1012276/AFS30_testsysteem_Stedin/Altium/Testopstelling DA_BOX_V2/BOM/Testopstelling_DA_BOX_Stedin_V2.xlsx

Comment | Description | Designator | Footprint | LibRef | Quantity
LM61495RPHR | No Description Available | 1 | RPH0016A | LM61495RPHR | 1
EEHZU1J151V | Aluminum Hybrid Polymer Capacitors 150uF 20% 63V Life 4000Hours AEC-Q200 RADIAL SMT | C1 | FP-EEH-G16-V-MFG | CMP-05428-001018-1 | 1
10uF | CAP CER 10UF 50V X7R 1210 | C2, C4 | FP-GRM32-MFG | CMP-2000-05261-2 | 2
1 uF | CAP CER 1 UF 50V 5% X7R 0603 | C3, C5, C12, C16 | FP-C0603C-CF-MFG | CMP-2006-03056-2 | 4
22μF | Multilayer Ceramic Capacitors 22μF ±20% 10V X5R SMD 0805 | C6, C7, C8 | FP-C2012-125-0_2-MFG | CMP-08246-005813-1 | 3
100nF | CAP CER 0.1UF 16V X7R 0402 | C9, C11, C24, C25, C28, C30, C32, C33, C39, C41, C42, C45, C48, C49, C50, C51, C52, C53, C54, C55, C56, C59, C60, C61, C62, C65, C67, C68, C69, C70 | FP-GRM15-MFG | CMP-2100-03641-2 | 30
10pF | CAP CER 10pF 16V X7R 0402 | C10 | FP-GRM15-MFG | CMP-2100-03641-2 | 1
4.7 uF | CAP CER 4.7 UF 50V 5% X7R 0603 | C13, C17, C29, C58 | FP-C0603C-CF-MFG | CMP-2006-03056-2 | 4
2.2 uF | CAP CER 2.2 UF 50V 5% X7R 0603 | C14, C15, C46, C47 | FP-C0603C-CF-MFG | CMP-2006-03056-2 | 4
10 UF | CAP CER 10 UF 16V X7R 0603 | C18, C20 | FP-CC0603-DA-MFG | CMP-2000-05002-2 | 2
0.1 uF | CAP CER 0.1UF 16V X7R 0603 | C19, C21 | FP-CC0603-DA-MFG | CMP-2000-05002-2 | 2
150 nF | CAP CER 0.1UF 16V X7R 0603 | C22 | FP-CC0603-DA-MFG | CMP-2000-05002-2 | 1
1nF | General Purpose Ceramic Capacitor, 0603, 1nF, 10%, X7R, 15%, 50V | C23, C26, C27 | FP-CC0603-DA-MFG | CMP-2000-05002-2 | 3
2.2 nF | AC0603 2.2 pF NP0 5.00% 50 V | C31 | FP-AC0603-MFG | CMP-03422-001062-1 | 1
68 pF | AC0603 68 pF NP0 5.00% 50 V | C34 | FP-AC0603-MFG | CMP-03422-001062-1 | 1
15 nF | CAP CER 15 nF 50V 5% X7R 0603 Eurocircuits generic components: GPC0603153 | C36, C38 | FP-C0603C-CF-MFG | CMP-2006-03056-2 | 2
330 pF | AC0603 330 pF NP0 5.00% 50 V | C37 | FP-AC0603-MFG | CMP-03422-001062-1 | 1
15 pF | AC0603 15 pF NP0 5.00% 50 V | C43, C44 | FP-AC0603-MFG | CMP-03422-001062-1 | 2
1uF | CAP CER 1UF 16V X7R 0402 | C57, C64, C66 | FP-GRM15-MFG | CMP-2100-03641-2 | 3
10nF | CAP CER 10nF 16V X7R 0402 | C63 | FP-GRM15-MFG | CMP-2100-03641-2 | 1
4.7uF | Polarized Capacitor (Radial) | C71 | TAN-A | Cap Pol1 | 1
475900001 |  | CN1 | MOLEX_47590001 | 475900001 | 1
ESDA6V1BC6 | 4-line ESD protection | D1 | 3 | ESDA6V1BC6 | 1
DNP_0603 | Is just 0603 footprint. So that you can solder 0603 components on it after you ordered youre PCB. | DNP1, DNP2 | DNP_0603_footprint | DNP_0603 | 2
DAC8564IAPW | Integrated Circuit | IC1 | SOP65P640X120-16N | DAC8564IAPW | 1
MAX22506EASA+ | Integrated Circuit | IC2 | SOIC127P600X175-8N | MAX22506EASA+ | 1
2269-2 | CONN DBL BANANA JACK TURRET | J1 | FP-2269-2-MFG | CMP-73906-000010-1 | 1
61500814221 |  | J2, J3, J4, J5, J6, J7, J8, J10, J15 | 61500814221 | CMP-1502-01695-2 | 9
TSW-104-22-G-S | GENERIC PART NUMBER: GPHA-1X04 CONN HEADER VERT 4POS 2.54MM | J9, J11, J12 | FP-TSW-104-22-G-S-MFG | CMP-02766-001236-1 | 3
FTSH-107-01-L-DV-K-A | Board Connector, 14 Contact(s), 2 Row(s), Male, Straight, 0.05 inch Pitch, Surface Mount Terminal, Locking, Receptacle | J14 | FTSH-107-XX-YYY-DV-K-A | FTSH-107-01-L-DV-K-A | 1
XAL6060-822MEC | 8.2 uH Inductor | L1 | XAL6060822MEC | XAL6060-822MEC | 1
ASMT-YTD7-0AA02 | LED | LED1 | ASMTYTD70AA02 | ASMT-YTD7-0AA02 | 1
SML-LX1206SRC-TR | LED | LED2 | SMLLX1206SRCTR | SML-LX1206SRC-TR | 1
150060VS75003 | LED | LED3 | 150060VS75003 | 150060VS75003 | 1
TSW-102-26-T-S | 0.025" SQ Post Header, Through-hole, Vertical, -55 to 105 degC, 2.54 mm Pitch, 2-Pin, Male, RoHS | P1, P2, P3, P4, P5, P6, P7, P8 | SMTC-TSW-102-26-XX-S | CMP-1024-00328-1 | 8
100k | RES 100K OHM 1% 1/16W 0402 | R1, R3 | FP-CRCW0402-C-e3-MFG | CMP-02407-010951-1 | 2
4.99k | RES Thick Film, 4.99kΩ, 1%, 0.063W, 100ppm/°C, 0402 | R2 | FP-CRCW0402-e3-MFG | CMP-2002-00057-2 | 1
43k | RES 43k OHM 1% 1/16W 0402 | R4 | FP-CRCW0402-C-e3-MFG | CMP-02407-010951-1 | 1
82k | RES 100K OHM 1% 1/16W 0402 | R5 | FP-CRCW0402-C-e3-MFG | CMP-02407-010951-1 | 1
270k | RES SMD 20K OHM 1% 1/8W 0805 | R6 | FP-ERJ6EN-MFG | CMP-2001-00027-2 | 1
20k | RES SMD 20K OHM 1% 1/8W 0805 | R7, R8 | FP-ERJ6EN-MFG | CMP-2001-00027-2 | 2
0 | CRCW12060000ZSTA Zero Ohm Resistor, Jumper, 1206 [3216 Metric], Thick Film, 250 mW, Surface Mount | R9, R10, R11, R12, R13, R14, R16, R17, R18, R19, R20, R21, R22, R23, R24, R25, R26, R27, R28, R29, R30, R31, R32, R33, R52, R55, R56, R65, R78 | FP-CRCW1206-MFG | CMP-00030-39388935-1 | 29
10k | Res Thick Film 0603 11kΩ 1% 0.1W ±100ppm/°C Molded SMD T/R, Res Thick Film 0603 10kΩ 1% 0.1W ±100ppm/°C Molded SMD T/R Generic part Eurocircuits: GPR060310K | R15, R35, R36, R38, R40, R43, R46, R49, R51, R53 | FP-RC1608-IPC_B | CMP-13261-004935-1 | 10
100 | Res Thick Film 0603 100Ω 1% 0.1W ±100ppm/°C Molded SMD T/R | R34, R37, R47 | FP-RC1608-IPC_B | CMP-13261-004935-1 | 3
620 | Res Thick Film 0603 620Ω 1% 0.1W ±100ppm/°C Molded SMD T/R | R39 | FP-RC1608-IPC_B | CMP-13261-004935-1 | 1
51k | Res Thick Film 0603 51kΩ 1% 0.1W ±100ppm/°C Molded SMD T/R | R41 | FP-RC1608-IPC_B | CMP-13261-004935-1 | 1
11k | Res Thick Film 0603 11kΩ 1% 0.1W ±100ppm/°C Molded SMD T/R | R42, R44, R48, R50 | FP-RC1608-IPC_B | CMP-13261-004935-1 | 4
3k | Res Thick Film 0603 3kΩ 1% 0.1W ±100ppm/°C Molded SMD T/R | R45 | FP-RC1608-IPC_B | CMP-13261-004935-1 | 1
22 | Res Thick Film 0603 22Ω 1% 0.1W ±100ppm/°C Molded SMD T/R Generic part Eurocircuits: GPR060310K | R54 | FP-RC1608-IPC_B | CMP-13261-004935-1 | 1
120 | CRCW12060000ZS120 Ohm Resistor, Jumper, 1206 [3216 Metric], Thick Film, 250 mW, Surface Mount | R57 | FP-CRCW1206-MFG | CMP-00030-39388935-1 | 1
39 | Res Thick Film 0603 39Ω 1% 0.1W ±100ppm/°C Molded SMD T/R Generic part Eurocircuits: GPR060310K | R58, R59 | FP-RC1608-IPC_B | CMP-13261-004935-1 | 2
82 | Res Thick Film 0603 82Ω 1% 0.1W ±100ppm/°C Molded SMD T/R Generic part Eurocircuits: GPR060310K | R60 | FP-RC1608-IPC_B | CMP-13261-004935-1 | 1
620 | Resistor | R61 | 0603R | Res1 | 1
47K | Resistor | R62 | 0603R | res1 | 1
10K | Resistor | R63, R67 | 0603R | Res1 | 2
220 | RES Thick Film, 220Ω, 1%, 0.125W, 100ppm/°C, 0805 | R64 | FP-CRCW0805-e3-MFG | CMP-2001-03682-2 | 1
4.7K | Resistor | R66 | 0603R | res1 | 1
0 | Chip Resistor, 0 Ohm, +/- 1%, 0.125 W, -55 to 155 degC, 0805 (2012 Metric), RoHS, Tape and Reel | R68, R69, R70, R71, R72, R73, R74, R75, R76 | RESC2013X70X40NL20T20 | CMP-1665-00002-5 | 9
0 | Chip Resistor, 0 Ohm, +/- 5%, 0.1 W, -55 to 155 degC, 0603 (1608 Metric), RoHS, Tape and Reel | R77 | RESC1608X55X25ML10T15 | CMP-2100-03667-1 | 1
Open | Circuit Breaker | SB1 | SB_0603 | Circuit Breaker | 1
B3F-1000 | Tactile Switch, SPST-NO, 0.05 A, 5 to 24 V, -25 to 70 degC, 4-Pin THD, RoHS, Bulk | SW1, SW2, SW3, SW4 | OMRON-B3F-1000-4_V | CMP-1677-00002-1 | 4
LM2776DBVR | IC REG CHARGE PUMP INV SOT23 | U1 | FP-DBV0006A-MFG | CMP-04918-000109-1 | 1
LT3021ES8#PBF | Low 160 mV Dropout Voltage, Internal PNP Pass Element, 200 mV Reference Voltage, 0.9 to 10 V Vin, Adjustable Vout, 8-pin SOIC (S8-8), -40 to 125 degC, Pb-Free | U2 | LT-S8-8_L | CMP-0476-01501-1 | 1
OPA1652AID | No Description Available | U3, U4, U5, U6 | D8 | OPA1652AID | 4
STM32F446ZET7 | ARM Cortex-M4 32-bit MCU+FPU, 512 KB Flash, 128 KB Internal RAM, 114 I/Os, 144-Pin LQFP, -40 to 105 degC, Tray | U7 | STM-LQFP144_M | CMP-0243-00227-1 | 1
STMPS2151STR |  | U8 | SOT-23-5L | STMPS2141STR | 1
ABM8G-12.000MHZ-18-D2Y-T | Crystal 12MHz ±20ppm (Tol) ±30ppm (Stability) 18pF FUND 120Ω 4-Pin SMD T/R | Y1 | FP-ABM8G-MFG | CMP-2000-05039-3 | 1
