1012276/AFS30_testsysteem_Stedin/Altium/Testopstelling DA_BOX_V1/Schemas/Testopstelling_DA_BOX_Stedin.pdf

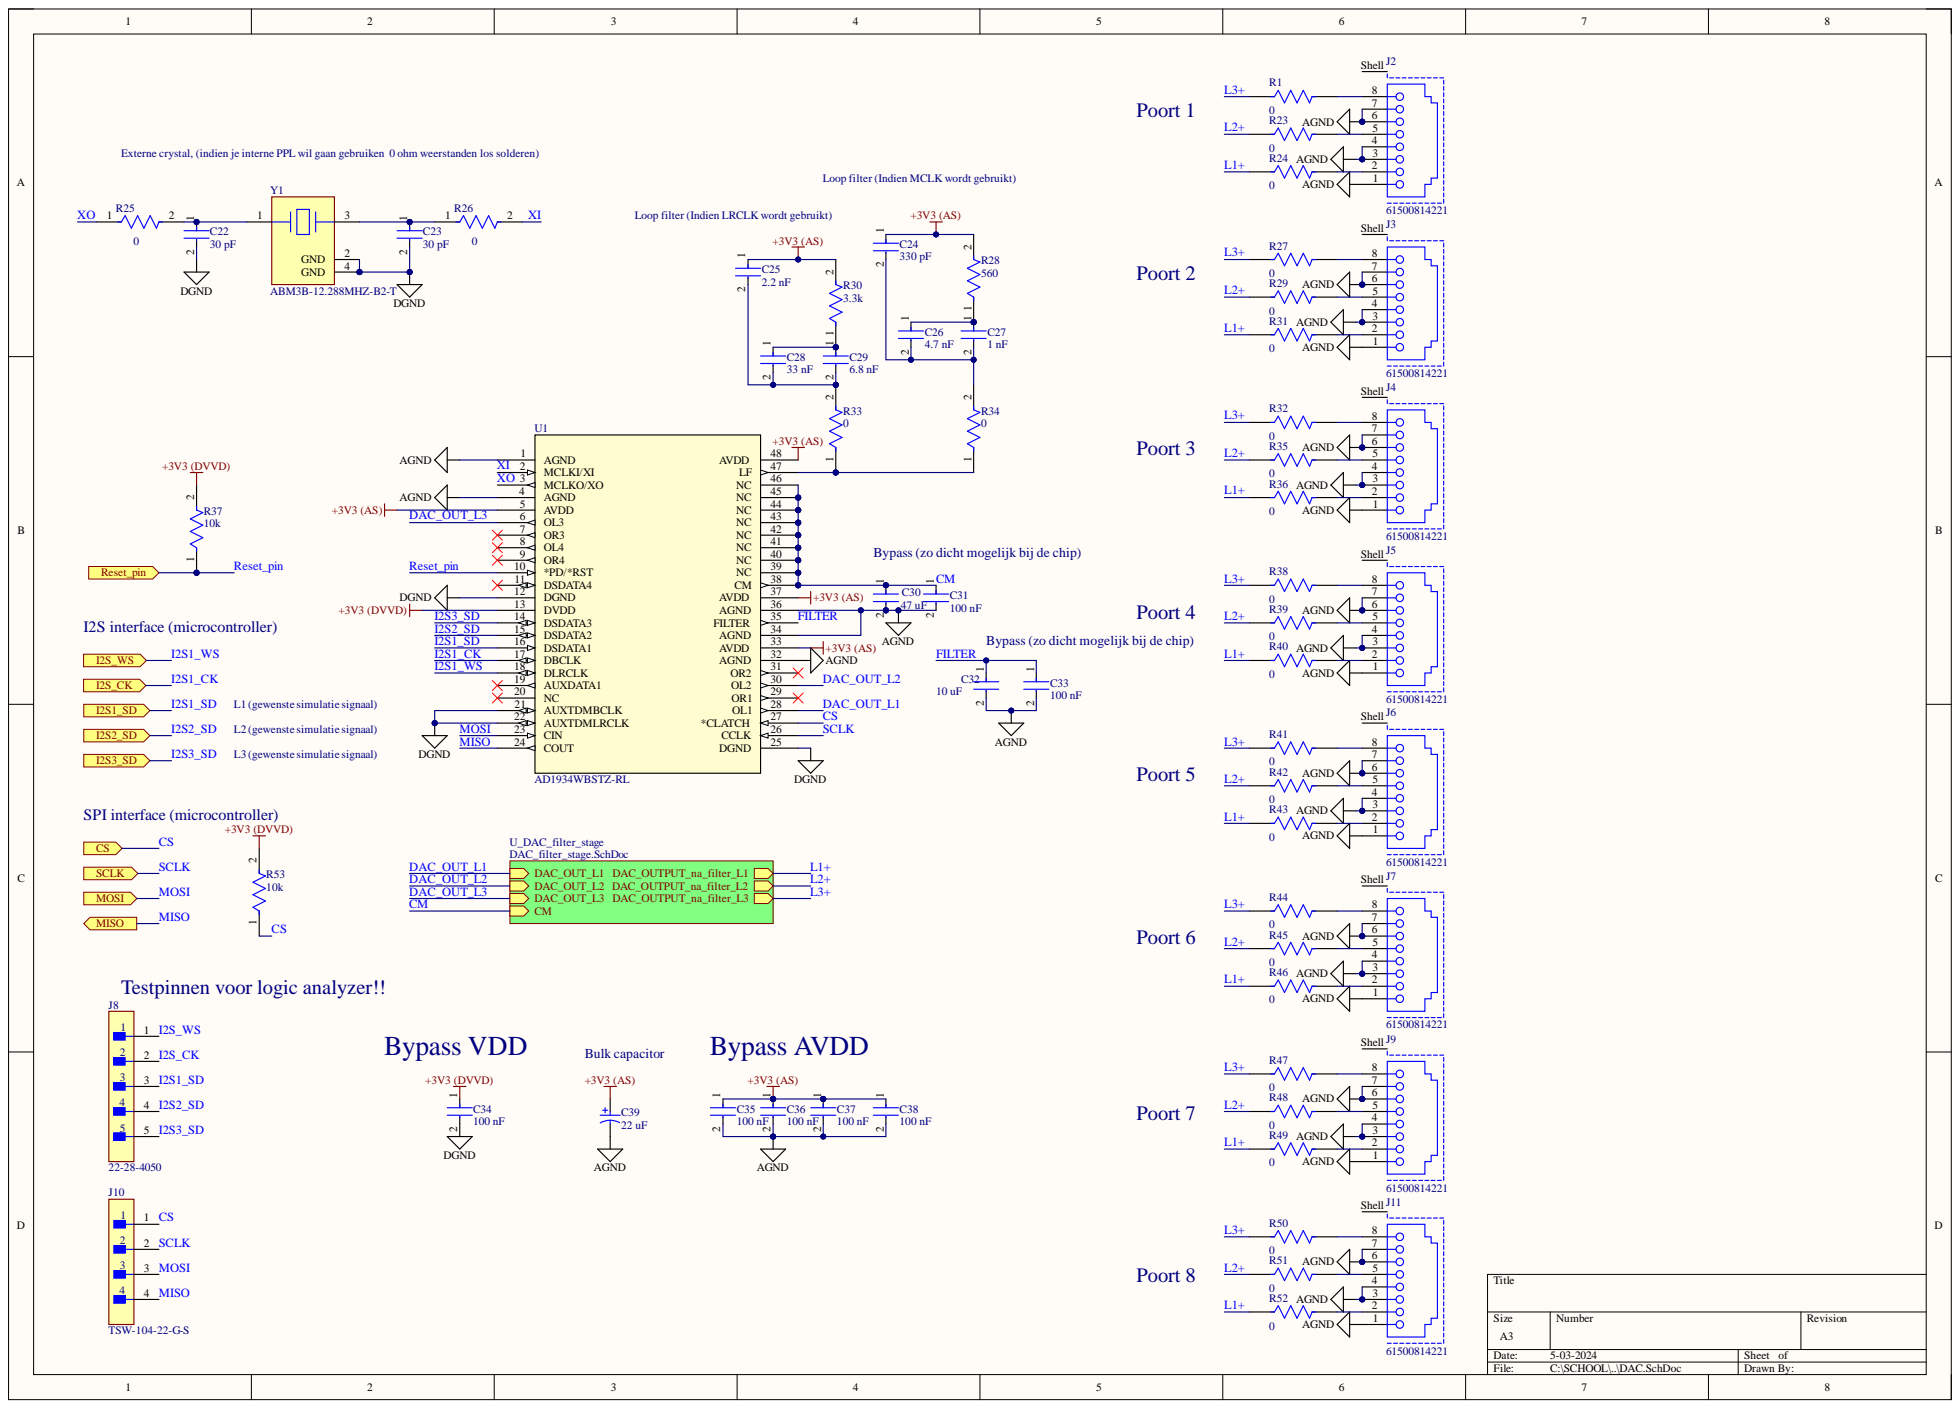
[picture p1: page 1]

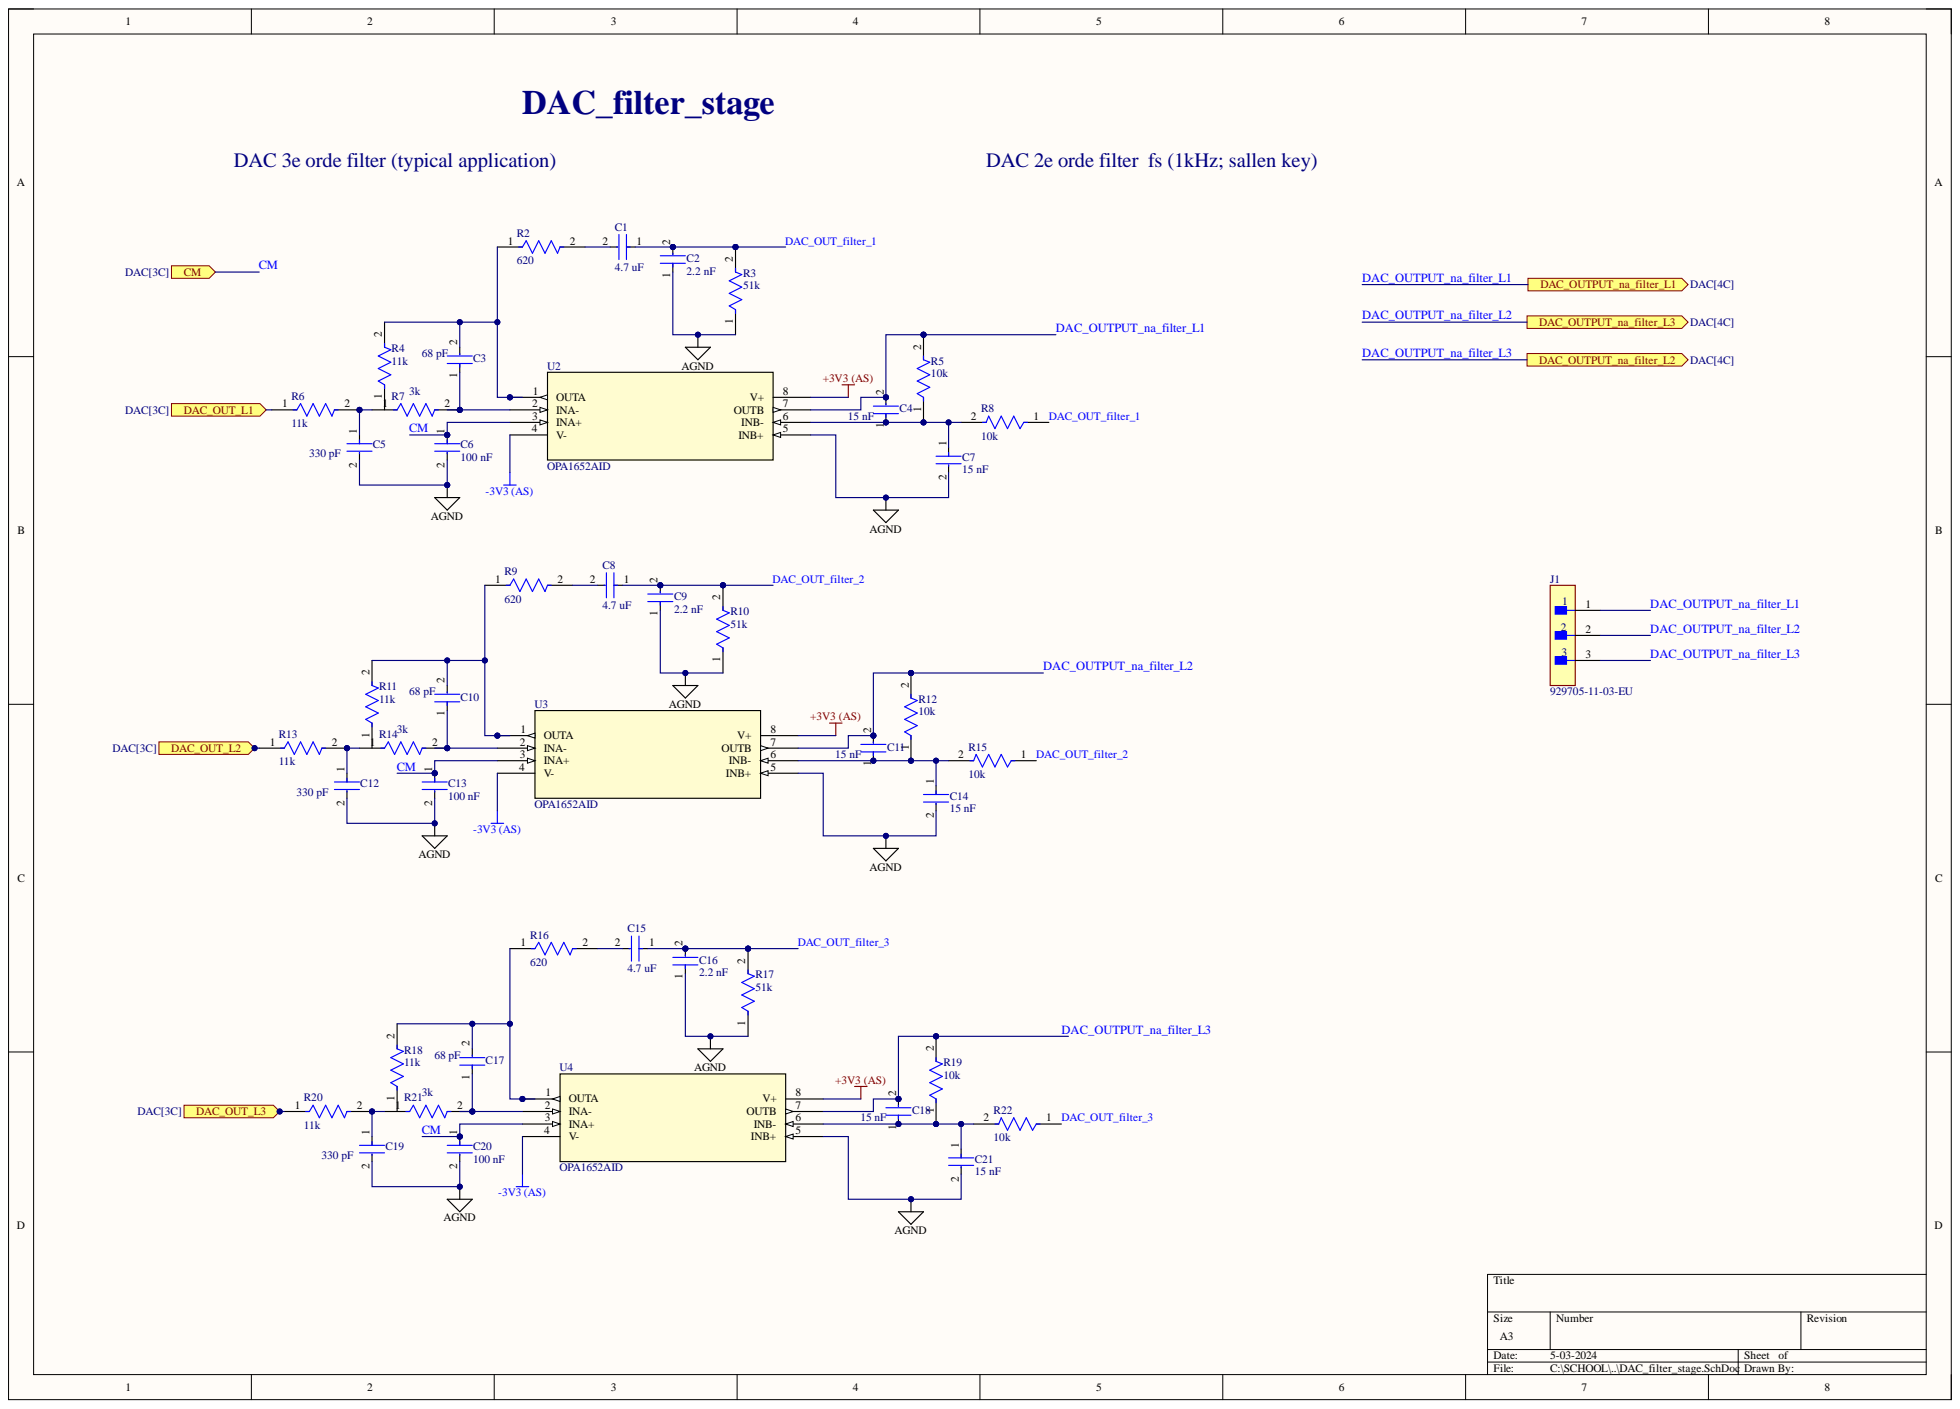
[picture p2: page 2]

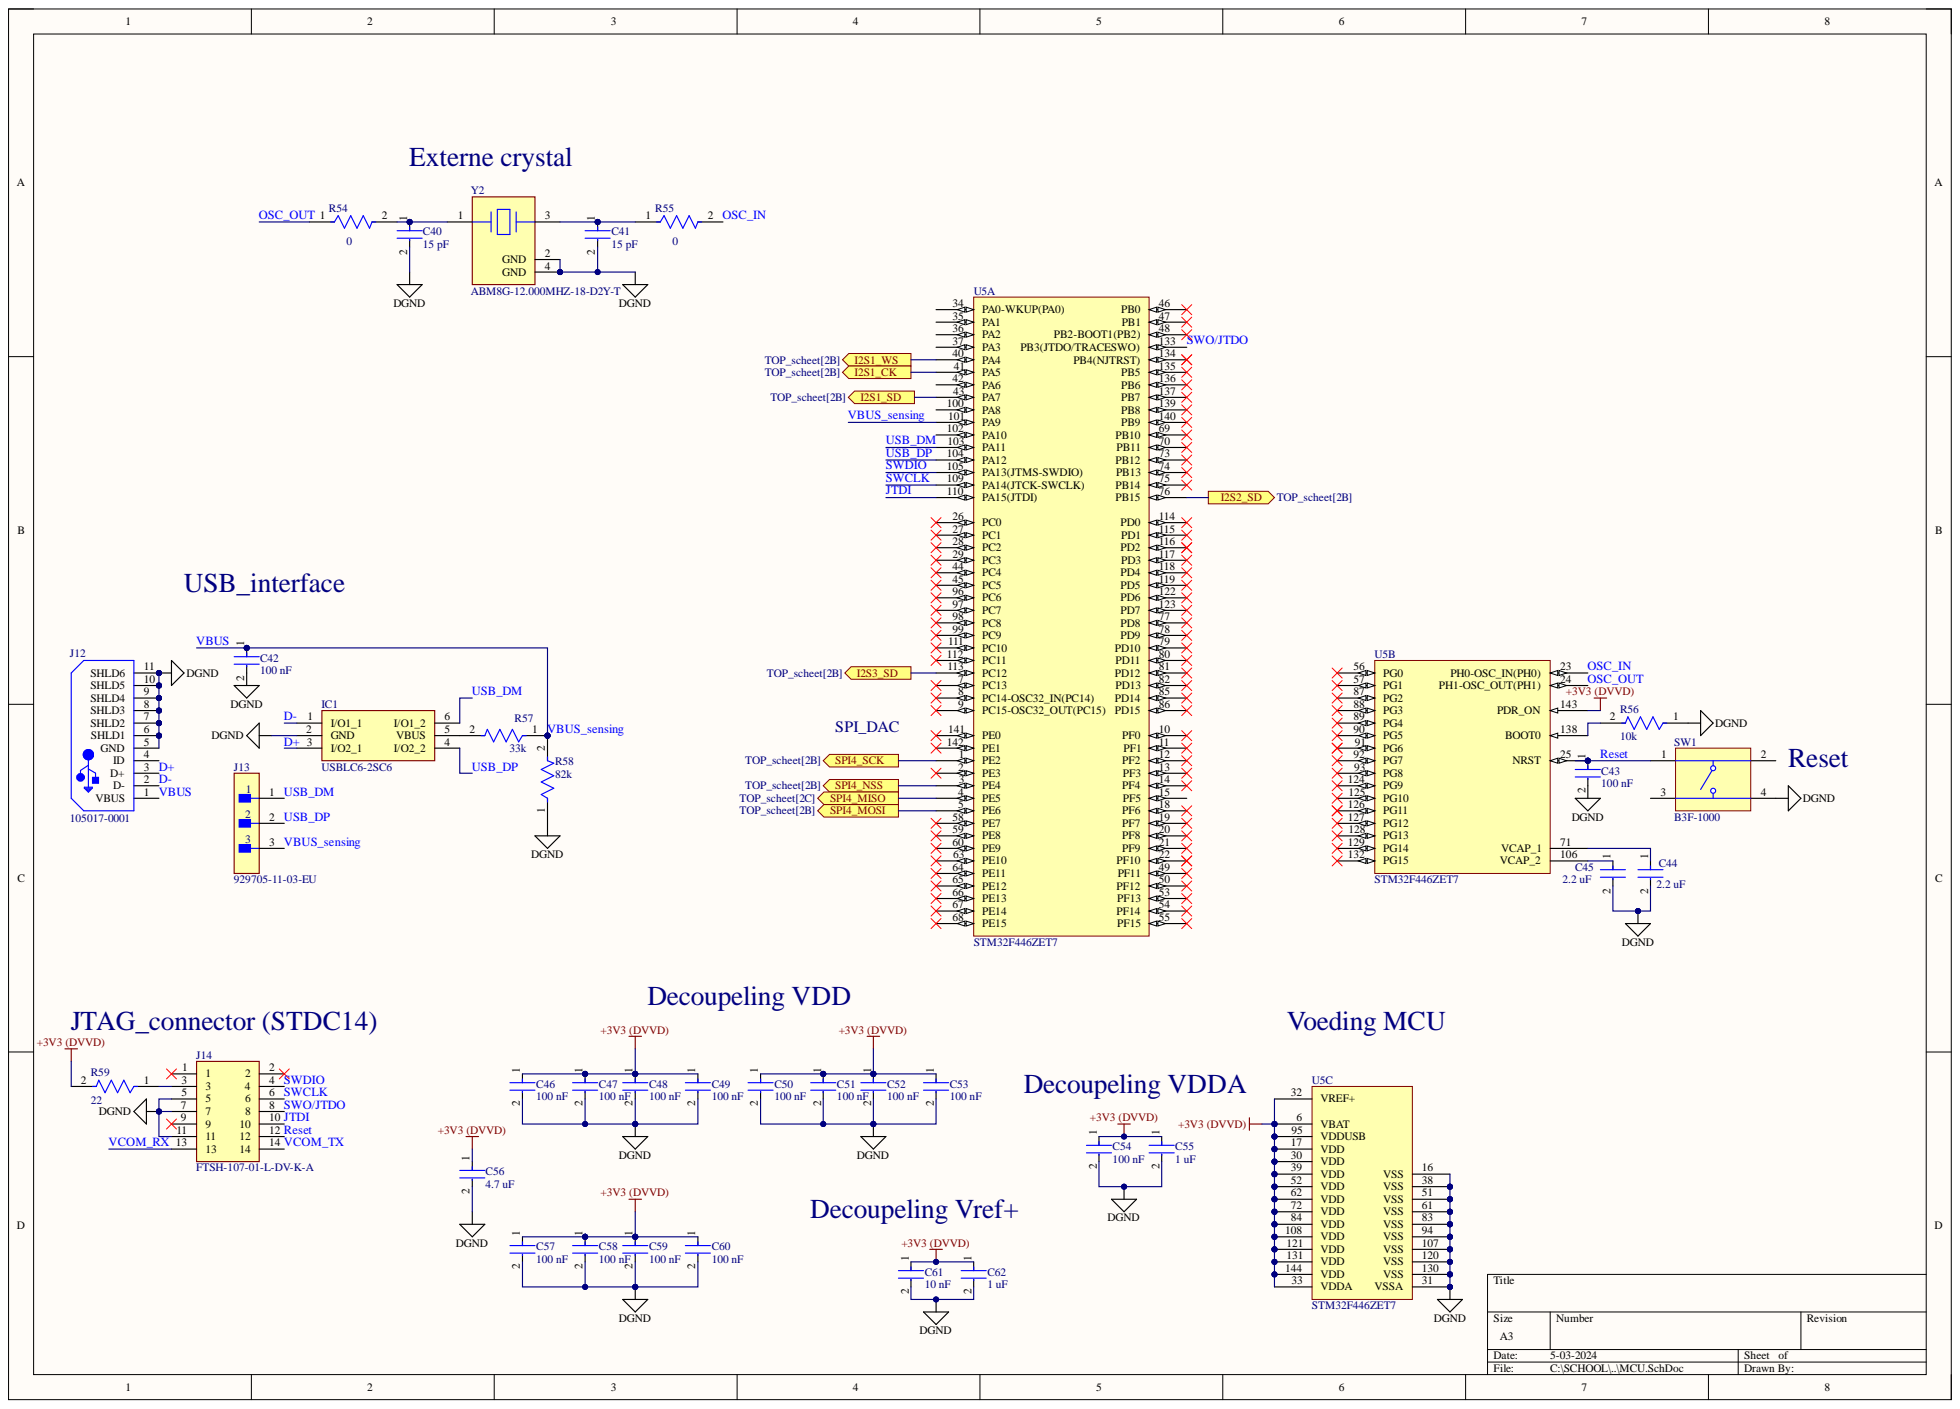
[picture p3: page 3]

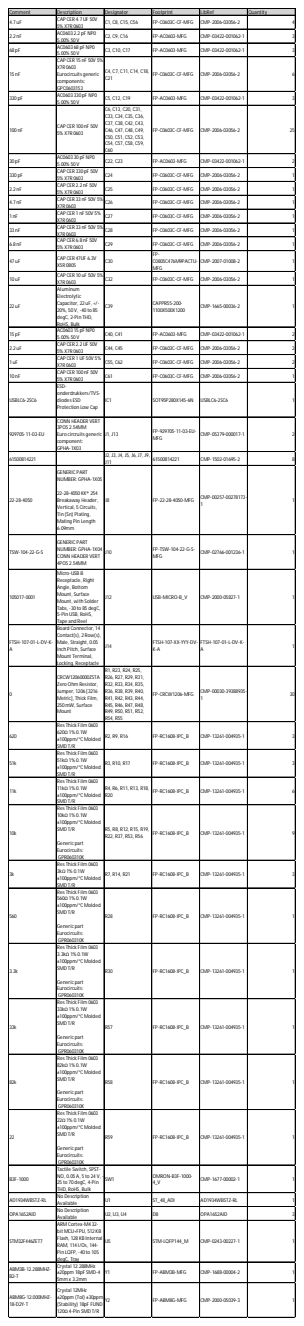
[picture p4: page 4]

4.7 uF | CAP CER 4.7UF 50V 5% X7R 0603 | C1, C8, C15, C56 | FP-C0603C-CF-MFG | CMP-2006-03056-2 | | 4

2.2 nF | AC0603 2.2 pF NP0 5.00% 50 V | C2, C9, C16 | FP-AC0603-MFG | CMP-03422-001062-1 | | 3

68 pF | AC0603 68 pF NP0 5.00% 50 V | C3, C10, C17 | FP-AC0603-MFG | CMP-03422-001062-1 | | 3

15 nF | CAP CER 15 nF 50V 5% X7R 0603 Eurocircuits generic components: GPC0603153 | C4, C7, C11, C14, C18, C21 | FP-C0603C-CF-MFG | CMP-2006-03056-2 | | 6

330 pF | AC0603 330 pF NP0 5.00% 50 V | C5, C12, C19 | FP-AC0603-MFG | CMP-03422-001062-1 | | 3

100 nF | CAP CER 100 nF 50V 5% X7R 0603 | C6, C13, C20, C31, C33, C34, C35, C36, C37, C38, C42, C43, C46, C47, C48, C49, C50, C51, C52, C53, C54, C57, C58, C59, C60 | FP-C0603C-CF-MFG | CMP-2006-03056-2 | 25

30 pF | AC0603 30 pF NP0 5.00% 50 V | C22, C23 | FP-AC0603-MFG | CMP-03422-001062-1 | | 2

330 pF | CAP CER 330 pF 50V 5% X7R 0603 | C24 | FP-C0603C-CF-MFG | CMP-2006-03056-2 | | 1

2.2 nF | CAP CER 2.2 nF 50V 5% X7R 0603 | C25 | FP-C0603C-CF-MFG | CMP-2006-03056-2 | | 1

4.7 nF | CAP CER 33 nF 50V 5% X7R 0603 | C26 | FP-C0603C-CF-MFG | CMP-2006-03056-2 | | 1

1 nF | CAP CER 1 nF 50V 5% X7R 0603 | C27 | FP-C0603C-CF-MFG | CMP-2006-03056-2 | | 1

33 nF | CAP CER 33 nF 50V 5% X7R 0603 | C28 | FP-C0603C-CF-MFG | CMP-2006-03056-2 | | 1

6.8 nF | CAP CER 6.8 nF 50V 5% X7R 0603 | C29 | FP-C0603C-CF-MFG | CMP-2006-03056-2 | | 1

47 uF | CAP CER 47UF 6.3V X5R 0805 | C30 | FP-C0805C476M9PACTU-MFG | CMP-2007-01008-2 | | 1

10 uF | CAP CER 10 uF 50V 5% X7R 0603 | C32 | FP-C0603C-CF-MFG | CMP-2006-03056-2 | | 1

22 uF | Aluminum Electrolytic Capacitor, 22 uF, +/-20%, 50 V, -40 to 85 degC, 2-Pin THD, RoHS, Bulk | C39 | CAPPR55-200-1100X500X1200 | CMP-1665-00036-2 | | 1

15 pF | AC0603 15 pF NP0 5.00% 50 V | C40, C41 | FP-AC0603-MFG | CMP-03422-001062-1 | | 2

2.2 uF | CAP CER 2.2UF 50V 5% X7R 0603 | C44, C45 | FP-C0603C-CF-MFG | CMP-2006-03056-2 | | 2

1 uF | CAP CER 1UF 50V 5% X7R 0603 | C55, C62 | FP-C0603C-CF-MFG | CMP-2006-03056-2 | | 2

10 nF | CAP CER 100 nF 50V 5% X7R 0603 | C61 | FP-C0603C-CF-MFG | CMP-2006-03056-2 | | 1

USBLC6-2SC6 | ESD-onderdrukkers/TVS-diodes ESD Protection Low Cap | IC1 | SOT95P280X145-6N | USBLC6-2SC6 | | 1

929705-11-03-EU | CONN HEADER VERT 3POS 2.54MM Euro circruits generic component: GPHA-1X03 | J1, J13 | FP-929705-11-03-EU-MFG | CMP-05379-000017-1 | | 2

61500814221 | | J2, J3, J4, J5, J6, J7, J9, J11 | 61500814221 | CMP-1502-01695-2 | | 8

22-28-4050 | GENERIC PART NUMBER: GPHA-1X05 22-28-4050 KK® 254 Breakaway Header, Vertical, 5 Circuits, Tin (Sn) Plating, Mating Pin Length 6.09mm | J8 | FP-22-28-4050-MFG | CMP-00257-00278173-1 | | 1

TSW-104-22-G-S | GENERIC PART NUMBER: GPHA-1X04 CONN HEADER VERT 4POS 2.54MM | J10 | FP-TSW-104-22-G-S-MFG | CMP-02766-001236-1 | | 1

105017-0001 | Micro-USB B Receptacle, Right Angle, Bottom Mount, Surface Mount, with Solder Tabs, -30 to 85 degC, 5-Pin USB, RoHS, Tape and Reel | J12 | USB-MICRO-B_V | CMP-2000-05827-1 | | 1

FTSH-107-01-L-DV-K-A | Board Connector, 14 Contact(s), 2 Row(s), Male, Straight, 0.05 inch Pitch, Surface Mount Terminal, Locking, Receptacle | J14 | FTSH-107-XX-YYY-DV-K-A | FTSH-107-01-L-DV-K-A | | 1

0 | CRCW12060000ZSTA Zero Ohm Resistor, Jumper, 1206 [3216 Metric], Thick Film, 250mW, Surface Mount | R1, R23, R24, R25, R26, R27, R29, R31, R32, R33, R34, R35, R36, R38, R39, R40, R41, R42, R43, R44, R45, R46, R47, R48, R49, R50, R51, R52, R54, R55 | FP-CRCW1206-MFG | CMP-00030-39388935-1 | 30

620 | Res Thick Film 0603 620Ω 1% 0.1W ±100ppm/°C Molded SMD T/R | R2, R9, R16 | FP-RC1608-IPC_B | CMP-13261-004935-1 | | 3

51k | Res Thick Film 0603 51kΩ 1% 0.1W ±100ppm/°C Molded SMD T/R | R3, R10, R17 | FP-RC1608-IPC_B | CMP-13261-004935-1 | | 3

11k | Res Thick Film 0603 11kΩ 1% 0.1W ±100ppm/°C Molded SMD T/R | R4, R6, R11, R13, R18, R20 | FP-RC1608-IPC_B | CMP-13261-004935-1 | | 6

10k | Res Thick Film 0603 10kΩ 1% 0.1W ±100ppm/°C Molded SMD T/R Generic part Eurocircuits: GPR060310K | R5, R8, R12, R15, R19, R22, R37, R53, R56 | FP-RC1608-IPC_B | CMP-13261-004935-1 | | 9

3k | Res Thick Film 0603 3kΩ 1% 0.1W ±100ppm/°C Molded SMD T/R | R7, R14, R21 | FP-RC1608-IPC_B | CMP-13261-004935-1 | | 3

560 | Res Thick Film 0603 560Ω 1% 0.1W ±100ppm/°C Molded SMD T/R Generic part Eurocircuits: GPR060310K | R28 | FP-RC1608-IPC_B | CMP-13261-004935-1 | | 1

3.3k | Res Thick Film 0603 3.3kΩ 1% 0.1W ±100ppm/°C Molded SMD T/R Generic part Eurocircuits: GPR060310K | R30 | FP-RC1608-IPC_B | CMP-13261-004935-1 | | 1

33k | Res Thick Film 0603 33kΩ 1% 0.1W ±100ppm/°C Molded SMD T/R Generic part Eurocircuits: GPR060310K | R57 | FP-RC1608-IPC_B | CMP-13261-004935-1 | | 1

82k | Res Thick Film 0603 82kΩ 1% 0.1W ±100ppm/°C Molded SMD T/R Generic part Eurocircuits: GPR060310K | R58 | FP-RC1608-IPC_B | CMP-13261-004935-1 | | 1

22 | Res Thick Film 0603 22Ω 1% 0.1W ±100ppm/°C Molded SMD T/R Generic part Eurocircuits: GPR060310K | R59 | FP-RC1608-IPC_B | CMP-13261-004935-1 | | 1

B3F-1000 | Tactile Switch, SPST-NO, 0.05 A, 5 to 24 V, -25 to 70 degC, 4-Pin THD, RoHS, Bulk | SW1 | OMRON-B3F-1000-4_V | CMP-1677-00002-1 | | 1

AD1934WBSTZ-RL | No Description Available | U1 | ST_48_ADI | AD1934WBSTZ-RL | | 1

OPA1652AID | No Description Available | U2, U3, U4 | D8 | OPA1652AID | | 3

STM32F446ZET7 | ARM Cortex-M4 32-bit MCU+FPU, 512 KB Flash, 128 KB Internal RAM, 114 I/Os, 144-Pin LQFP, -40 to 105 degC, Tray | U5 | STM-LQFP144_M | CMP-0243-00227-1 | | 1

ABM3B-12.288MHZ-B2-T | Crystal 12.288MHz ±20ppm 18pF SMD-4 5mm x 3.2mm | Y1 | FP-ABM3B-MFG | CMP-1688-00004-2 | | 1

ABM8G-12.000MHZ-18-D2Y-T | Crystal 12MHz ±20ppm (Tol) ±30ppm (Stability) 18pF FUND 120Ω 4-Pin SMD T/R | Y2 | FP-ABM8G-MFG | CMP-2000-05039-3 | | 1
