1012276/AFS30_testsysteem_Stedin/(list of files, drawings)

Other design files:
Altium/Testopstelling DA_BOX_V1/Schemas/DAC.SchDoc
Altium/Testopstelling DA_BOX_V1/Schemas/DAC_filter_stage.SchDoc
Altium/Testopstelling DA_BOX_V1/Schemas/MCU.SchDoc
Altium/Testopstelling DA_BOX_V1/Schemas/RS485_tranceiver.SchDoc
Altium/Testopstelling DA_BOX_V1/Schemas/TOP_scheet.SchDoc
Altium/Testopstelling DA_BOX_V1/Schemas/User_interface.SchDoc
Altium/Testopstelling DA_BOX_V1/Schemas/VOEDING.SchDoc
Altium/Testopstelling DA_BOX_V2/PCB Project/Testopstelling_DA_BOX_Stedin_V2.PrjPcb
Altium/Testopstelling DA_BOX_V2/Schema's/DAC.SchDoc
Altium/Testopstelling DA_BOX_V2/Schema's/DAC_filter_stage.SchDoc
Altium/Testopstelling DA_BOX_V2/Schema's/MCU.SchDoc
Altium/Testopstelling DA_BOX_V2/Schema's/RS485_tranceiver.SchDoc
Altium/Testopstelling DA_BOX_V2/Schema's/TOP_sheet.SchDoc
Altium/Testopstelling DA_BOX_V2/Schema's/USB.SchDoc
Altium/Testopstelling DA_BOX_V2/Schema's/User_interface.SchDoc
Altium/Testopstelling DA_BOX_V2/Schema's/Voeding.SchDoc
