1012276/AFS30_testsysteem_Stedin/STM32cube_IDE/Final code/Core/Src/main.c

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
/* Includes ------------------------------------------------------------------*/
#include "main.h"
#include "cmsis_os.h"
#include "usb_device.h"

/* USER CODE BEGIN Includes */
#include <string.h>
#include <stdio.h>
#include <stdbool.h>

#include <math.h>
#include <stdint.h>
#include <stdlib.h>
#include "stm32f4xx_hal.h"
/* USER CODE END Includes */

/* USER CODE BEGIN PTD */
typedef enum {
	STATUS_IDLE,
    STATUS_WACHTEN_OP_INSTELLINGEN,
    STATUS_GEREED,
    STATUS_TEST_GESTART,
    STATUS_TEST_GEPAUZEERD,
	STATUS_TEST_GESTOPT,
    STATUS_TEST_VOLTOOID
} TestStatus;
/* USER CODE END PTD */

/* USER CODE BEGIN PD */
#define BLAUWE_LED_PIN GPIO_PIN_1
#define BLAUWE_LED_PORT GPIOF

#define GROENE_LED_PIN GPIO_PIN_2
#define GROENE_LED_PORT GPIOF

#define RODE_LED_PIN GPIO_PIN_3
#define RODE_LED_PORT GPIOF

#define START_KNOP_PIN GPIO_PIN_13
#define START_KNOP_PORT GPIOC

#define PAUZEER_KNOP_PIN GPIO_PIN_14
#define PAUZEER_KNOP_PORT GPIOC

#define STOP_KNOP_PIN GPIO_PIN_15
#define STOP_KNOP_PORT GPIOC

#define GPIO_PORT_VBUS GPIOA   // De GPIO-poort voor VBUS
#define GPIO_PIN_VBUS  GPIO_PIN_9   // De specifieke pin


#define BUFFER_SIZE 1024   // Data buffer voor USB
// De data die wordt doorgestuurd naar de GUI voor de status updates
#define WAITING_FOR_SETTINGS "WACHT_OP_INSTELLINGEN"
#define READY_STATUS "GEREED"
#define TEST_RUNNING "BEZIG_MET_TEST"
#define TEST_PAUSED "GEPAUZEERD"
#define TEST_COMPLETED "VOLTOOID"
#define TEST_STOPPED "GESTOPT"

#define SPI_TIMEOUT 1000
#define DAC8564_SEQUENTIANALY_WRITE_UPDATE 0x10
#define VREF 2.5
#define PI 3.14159265
#define SAMPLE_RATE 48000
#define FREQUENCY 50   //Grondsignaal frequentie
#define NUM_SAMPLES (SAMPLE_RATE / FREQUENCY)
#define PHASE_SHIFT_120_DEG (2.0 * PI / 3.0)  // 120-degree phase shift
#define PHASE_SHIFT_240_DEG (4.0 * PI / 3.0)  // 240-degree phase shift








/* USER CODE END PD */

I2S_HandleTypeDef hi2s1;

SPI_HandleTypeDef hspi2;

TIM_HandleTypeDef htim2;

UART_HandleTypeDef huart1;
UART_HandleTypeDef huart3;

/* Definitions for defaultTask */
osThreadId_t defaultTaskHandle;
const osThreadAttr_t defaultTask_attributes = {
  .name = "defaultTask",
  .stack_size = 512 * 4,
  .priority = (osPriority_t) osPriorityNormal,
};
/* Definitions for KnopTASK */
osThreadId_t KnopTASKHandle;
const osThreadAttr_t KnopTASK_attributes = {
  .name = "KnopTASK",
  .stack_size = 128 * 4,
  .priority = (osPriority_t) osPriorityNormal,
};
/* Definitions for LedTASK */
osThreadId_t LedTASKHandle;
const osThreadAttr_t LedTASK_attributes = {
  .name = "LedTASK",
  .stack_size = 128 * 4,
  .priority = (osPriority_t) osPriorityNormal,
};
/* Definitions for Active_TASK */
osThreadId_t Active_TASKHandle;
const osThreadAttr_t Active_TASK_attributes = {
  .name = "Active_TASK",
  .stack_size = 128 * 4,
  .priority = (osPriority_t) osPriorityLow,
};
/* USER CODE BEGIN PV */

char receivedData[BUFFER_SIZE];  // Buffer om ontvangen gegevens van PC op te slaan
uint32_t receivedLength = 0;  // Houd de lengte van de ontvangen data bij

// Variabelen voor het berekenen van het gewenste simulatiesignaal.
volatile uint16_t sample_index = 0;
volatile uint32_t seconds_elapsed = 0;
volatile uint8_t dac_update_flag = 0;
volatile uint32_t Timer_counter = 0;
volatile int current_scenario = 1;

// variabelen om het gewenste simulatie signaal te berekenen.
float AMPLITUDE;

float HARMONIC_3, HARMONIC_5, HARMONIC_7, HARMONIC_9, HARMONIC_11, HARMONIC_13;


uint16_t sine_wave_A_scenario[6][NUM_SAMPLES];
uint16_t sine_wave_B_scenario[6][NUM_SAMPLES];
uint16_t sine_wave_C_scenario[6][NUM_SAMPLES];

uint16_t* current_sine_wave_A;
uint16_t* current_sine_wave_B;
uint16_t* current_sine_wave_C;


float stroom_s1 = 0.0;
float stroom_s2 = 0.0;
float stroom_s3 = 0.0;

// Globale variabelen voor THD scenario's
float thd_s1_rms = 0.0, thd_s2_rms = 0.0, thd_s3_rms = 0.0;
int thd_s1_3h = 0, thd_s1_5h = 0, thd_s1_7h = 0, thd_s1_9h = 0,
    thd_s1_11h = 0, thd_s1_13h = 0;

int thd_s2_3h = 0, thd_s2_5h = 0, thd_s2_7h = 0, thd_s2_9h = 0,
    thd_s2_11h = 0, thd_s2_13h = 0;

int thd_s3_3h = 0, thd_s3_5h = 0, thd_s3_7h = 0, thd_s3_9h = 0,
    thd_s3_11h = 0, thd_s3_13h = 0;

// De initiële status bij het aansluiten van de voeding
TestStatus huidig_status = STATUS_IDLE;

volatile bool usb_busy = false;  // Vlag om aan te geven of USB-communicatie bezig i


/* USER CODE END PV */

void SystemClock_Config(void);
static void MX_GPIO_Init(void);
static void MX_USART1_UART_Init(void);
static void MX_USART3_UART_Init(void);
static void MX_TIM2_Init(void);
static void MX_I2S1_Init(void);
static void MX_SPI2_Init(void);
void StartDefaultTask(void *argument);
void KnopThread(void *argument);
void Status_Thread(void *argument);
void Display_ACTIVE_scenario(void *argument);

/* USER CODE BEGIN 0 */

/*  Functies voor DAC */
/* DAC CODE BEGIN*/
void calculate_three_phase_sine_wave_samples(uint16_t* wave_A, uint16_t* wave_B, uint16_t* wave_C) {
    for (int i = 0; i < NUM_SAMPLES; i++) {
        double t = (double)i / SAMPLE_RATE;

        // Phase A with harmonic distortion
        double sample_A = AMPLITUDE * sin(2 * PI * FREQUENCY * t);
        sample_A += HARMONIC_3 * AMPLITUDE * sin(2 * PI * 3 * FREQUENCY * t);
        sample_A += HARMONIC_5 * AMPLITUDE * sin(2 * PI * 5 * FREQUENCY * t);
        sample_A += HARMONIC_7 * AMPLITUDE * sin(2 * PI * 7 * FREQUENCY * t);
        sample_A += HARMONIC_9 * AMPLITUDE * sin(2 * PI * 9 * FREQUENCY * t);
        sample_A += HARMONIC_11 * AMPLITUDE * sin(2 * PI * 11 * FREQUENCY * t);
        sample_A += HARMONIC_13 * AMPLITUDE * sin(2 * PI * 13 * FREQUENCY * t);

        if (sample_A >= 2.5)
        {
        	sample_A= 2.5;
        }
        else if (sample_A <= -2.5)
		{
			sample_A= -2.5;
		}

        wave_A[i] = (uint16_t)((65536 / (2 * VREF)) * (sample_A + VREF));

        // Phase B with harmonic distortion (120 degrees shifted)

        double sample_B = AMPLITUDE * sin(2 * PI * FREQUENCY * t + PHASE_SHIFT_120_DEG);
        sample_B += HARMONIC_3 * AMPLITUDE * sin(2 * PI * 3 * FREQUENCY * t + PHASE_SHIFT_120_DEG);
        sample_B += HARMONIC_5 * AMPLITUDE * sin(2 * PI * 5 * FREQUENCY * t + PHASE_SHIFT_120_DEG);
        sample_B += HARMONIC_7 * AMPLITUDE * sin(2 * PI * 7 * FREQUENCY * t + PHASE_SHIFT_120_DEG);
        sample_B += HARMONIC_9 * AMPLITUDE * sin(2 * PI * 9 * FREQUENCY * t + PHASE_SHIFT_120_DEG);
        sample_B += HARMONIC_11 * AMPLITUDE * sin(2 * PI * 11 * FREQUENCY * t + PHASE_SHIFT_120_DEG);
        sample_B += HARMONIC_13 * AMPLITUDE * sin(2 * PI * 13 * FREQUENCY * t + PHASE_SHIFT_120_DEG);

        if (sample_B >= 2.5)
        {
        	sample_B= 2.5;
        }
        else if (sample_B <= -2.5)
		{
			sample_B= -2.5;
		}

        wave_B[i] = (uint16_t)((65536 / (2 * VREF)) * (sample_B + VREF));


        // Phase C with harmonic distortion (240 degrees shifted)
        double sample_C = AMPLITUDE * sin(2 * PI * FREQUENCY * t + PHASE_SHIFT_240_DEG);
        sample_C += HARMONIC_3 * AMPLITUDE * sin(2 * PI * 3 * FREQUENCY * t + PHASE_SHIFT_240_DEG);
        sample_C += HARMONIC_5 * AMPLITUDE * sin(2 * PI * 5 * FREQUENCY * t + PHASE_SHIFT_240_DEG);
        sample_C += HARMONIC_7 * AMPLITUDE * sin(2 * PI * 7 * FREQUENCY * t + PHASE_SHIFT_240_DEG);
        sample_C += HARMONIC_9 * AMPLITUDE * sin(2 * PI * 9 * FREQUENCY * t + PHASE_SHIFT_240_DEG);
        sample_C += HARMONIC_11 * AMPLITUDE * sin(2 * PI * 11 * FREQUENCY * t + PHASE_SHIFT_240_DEG);
        sample_C += HARMONIC_13 * AMPLITUDE * sin(2 * PI * 13 * FREQUENCY * t + PHASE_SHIFT_240_DEG);

        if (sample_C >= 2.5)
        {
        	sample_C= 2.5;
        }
        else if (sample_C <= -2.5)
		{
			sample_C= -2.5;
		}
        wave_C[i] = (uint16_t)((65536 / (2 * VREF)) * (sample_C + VREF));
    }
}

////// Function to select the test scenario and calculate its samples
void select_test_scenario(int scenario_number) {
    switch (scenario_number) {
		case 1:  // Stroom scenario 1
			AMPLITUDE = (stroom_s1 / 10000) *sqrt(2.0);
			HARMONIC_3 = 0; HARMONIC_5 = 0; HARMONIC_7 = 0; HARMONIC_9 = 0;
			HARMONIC_11 = 0; HARMONIC_13 = 0;
			calculate_three_phase_sine_wave_samples(sine_wave_A_scenario[0], sine_wave_B_scenario[0], sine_wave_C_scenario[0]);
			break;
		case 2:  // Stroom scenario 2
			AMPLITUDE = (stroom_s2 / 10000) *sqrt(2.0);
			HARMONIC_3 = 0; HARMONIC_5 = 0; HARMONIC_7 = 0; HARMONIC_9 = 0;
			HARMONIC_11 = 0; HARMONIC_13 = 0;
			calculate_three_phase_sine_wave_samples(sine_wave_A_scenario[1], sine_wave_B_scenario[1], sine_wave_C_scenario[1]);
			break;
        case 3:  // Stroom scenario 3
            AMPLITUDE = (stroom_s3 / 10000) *sqrt(2.0);
            HARMONIC_3 = 0; HARMONIC_5 = 0; HARMONIC_7 = 0; HARMONIC_9 = 0;
            HARMONIC_11 = 0; HARMONIC_13 = 0;
            calculate_three_phase_sine_wave_samples(sine_wave_A_scenario[2], sine_wave_B_scenario[2], sine_wave_C_scenario[2]);
            break;
        case 4:  // THD scenario 1
            AMPLITUDE = (thd_s1_rms / 10000) *sqrt(2.0);
            HARMONIC_3 = thd_s1_3h / 100.0;
            HARMONIC_5 = thd_s1_5h / 100.0;
            HARMONIC_7 = thd_s1_7h / 100.0;
            HARMONIC_9 = thd_s1_9h / 100.0;
            HARMONIC_11 = thd_s1_11h / 100.0;
            HARMONIC_13 = thd_s1_13h / 100.0;
            calculate_three_phase_sine_wave_samples(sine_wave_A_scenario[3], sine_wave_B_scenario[3], sine_wave_C_scenario[3]);
            break;
        case 5:  // THD scenario 2
            AMPLITUDE = (thd_s2_rms / 10000) *sqrt(2.0);
            HARMONIC_3 = thd_s2_3h / 100.0;
            HARMONIC_5 = thd_s2_5h / 100.0;
            HARMONIC_7 = thd_s2_7h / 100.0;
            HARMONIC_9 = thd_s2_9h / 100.0;
            HARMONIC_11 = thd_s2_11h / 100.0;
            HARMONIC_13 = thd_s2_13h / 100.0;
            calculate_three_phase_sine_wave_samples(sine_wave_A_scenario[4], sine_wave_B_scenario[4], sine_wave_C_scenario[4]);
            break;
        case 6:  // THD scenario 3
            AMPLITUDE = (thd_s3_rms / 10000) *sqrt(2.0);
            HARMONIC_3 = thd_s3_3h / 100.0;
            HARMONIC_5 = thd_s3_5h / 100.0;
            HARMONIC_7 = thd_s3_7h / 100.0;
            HARMONIC_9 = thd_s3_9h / 100.0;
            HARMONIC_11 = thd_s3_11h / 100.0;
            HARMONIC_13 = thd_s3_13h / 100.0;
            calculate_three_phase_sine_wave_samples(sine_wave_A_scenario[5], sine_wave_B_scenario[5], sine_wave_C_scenario[5]);
            break;
    }
}


void DAC8564_Write(uint16_t channel, uint16_t value) {
    uint8_t data[3];
    data[0] = DAC8564_SEQUENTIANALY_WRITE_UPDATE | (channel << 1);  // Set command and channel
    data[1] = (value >> 8) & 0xFF;  // MSB
    data[2] = value & 0xFF;  // LSB

    HAL_GPIO_WritePin(GPIOB, SPI_SYNC_Pin, GPIO_PIN_RESET);  // CS Low
    HAL_SPI_Transmit(&hspi2, data, 3, SPI_TIMEOUT);
    HAL_GPIO_WritePin(GPIOB, SPI_SYNC_Pin, GPIO_PIN_SET);  // CS High
}


void DAC8564_Wake_up(void) {

	uint16_t nul_volt = ((65536 / (2 * VREF)) * (0 + VREF));
	DAC8564_Write(0, nul_volt);
	DAC8564_Write(1, nul_volt);
	DAC8564_Write(2, nul_volt);

}


void HAL_TIM_PeriodElapsedCallback(TIM_HandleTypeDef *htim) {
    if (htim->Instance == TIM2) {

     if ((huidig_status == STATUS_TEST_GESTART && usb_busy == false)  || huidig_status == STATUS_TEST_GEPAUZEERD  || huidig_status == STATUS_TEST_VOLTOOID)
		{
			if (!(huidig_status == STATUS_TEST_GEPAUZEERD)) {



						Timer_counter++;
						if (Timer_counter== 48000) {
								seconds_elapsed++;
								Timer_counter=0;
								// Wissel scenario na 12 seconden
								if (seconds_elapsed >=12) {
									seconds_elapsed = 0;

				//    	             Ga door naar het volgende scenario
									current_scenario++;
									if (current_scenario > 6) {
										update_status(STATUS_TEST_VOLTOOID);
										current_scenario = 6;

									}else {

										// Wissel de actieve buffers naar de nieuwe berekende golfvormen
										current_sine_wave_A = sine_wave_A_scenario[current_scenario - 1];
										current_sine_wave_B = sine_wave_B_scenario[current_scenario - 1];
										current_sine_wave_C = sine_wave_C_scenario[current_scenario - 1];
										sample_index =0;
									}

								}



						}
				}else{

					Timer_counter=0;
				}

				DAC8564_Write(0, current_sine_wave_A[sample_index]);  // Phase A on DAC A
				DAC8564_Write(1, current_sine_wave_B[sample_index]);  // Phase B on DAC B
				DAC8564_Write(2, current_sine_wave_C[sample_index]);  // Phase C on DAC C

				// Verhoog de sample index
				sample_index = (sample_index + 1) % NUM_SAMPLES;



		}
    }
}

void SET_refference() {
    uint8_t data[3];
    data[0] = 0x01;
    data[1] = 0x10;
    data[2] = 0x00;

    HAL_GPIO_WritePin(GPIOB, SPI_SYNC_Pin, GPIO_PIN_RESET);
    HAL_SPI_Transmit(&hspi2, data, 3, SPI_TIMEOUT);
    HAL_GPIO_WritePin(GPIOB, SPI_SYNC_Pin, GPIO_PIN_SET);
}
/* DAC CODE END*/


/*  Functies voor user interface */
/* Userinterface CODE BEGIN*/
void zet_blauw_licht_aan() {
    HAL_GPIO_WritePin(BLAUWE_LED_PORT, BLAUWE_LED_PIN, GPIO_PIN_SET);
    HAL_GPIO_WritePin(GROENE_LED_PORT, GROENE_LED_PIN, GPIO_PIN_RESET);
    HAL_GPIO_WritePin(RODE_LED_PORT, RODE_LED_PIN, GPIO_PIN_RESET);
}

void zet_groen_licht_aan() {
    HAL_GPIO_WritePin(BLAUWE_LED_PORT, BLAUWE_LED_PIN, GPIO_PIN_RESET);
    HAL_GPIO_WritePin(GROENE_LED_PORT, GROENE_LED_PIN, GPIO_PIN_SET);
    HAL_GPIO_WritePin(RODE_LED_PORT, RODE_LED_PIN, GPIO_PIN_RESET);
}

void zet_rood_licht_aan() {
    HAL_GPIO_WritePin(BLAUWE_LED_PORT, BLAUWE_LED_PIN, GPIO_PIN_RESET);
    HAL_GPIO_WritePin(GROENE_LED_PORT, GROENE_LED_PIN, GPIO_PIN_RESET);
    HAL_GPIO_WritePin(RODE_LED_PORT, RODE_LED_PIN, GPIO_PIN_SET);
}

void groen_knipperend() {
	HAL_GPIO_WritePin(BLAUWE_LED_PORT, BLAUWE_LED_PIN, GPIO_PIN_RESET);
	HAL_GPIO_WritePin(RODE_LED_PORT, RODE_LED_PIN, GPIO_PIN_RESET);
	HAL_GPIO_TogglePin(GROENE_LED_PORT, GROENE_LED_PIN);


}

void blauw_knipperend() {
    HAL_GPIO_WritePin(GROENE_LED_PORT, GROENE_LED_PIN, GPIO_PIN_RESET);
    HAL_GPIO_WritePin(RODE_LED_PORT, RODE_LED_PIN, GPIO_PIN_RESET);
    HAL_GPIO_TogglePin(BLAUWE_LED_PORT, BLAUWE_LED_PIN);
}

void update_status(TestStatus nieuwe_status) {
    huidig_status = nieuwe_status;
}

/* Userinterface CODE END*/



/* USB_GUI_ CODE BEGIN*/
void send_active_scenario_to_gui(int scenario_number) {
    char scenario_message[64];
    sprintf(scenario_message, "ACTIEF_SCENARIO=%d\n", scenario_number);
    send_status_to_gui(scenario_message);  // Verstuur het scenario

}


void send_status_to_gui(char* status_message) {
    CDC_Transmit_FS((uint8_t *)status_message, strlen(status_message));

}




// Simuleer de ontvangst van instellingen en stuur statusupdates naar de GUI
void receive_settings_and_update_status(void) {
    // Status wachten op instellingen
	update_status (STATUS_WACHTEN_OP_INSTELLINGEN);

}

void CheckReceivedData(void)
{
  // Check of data is ontvangen.
  if (receivedLength > 0) {
    parse_received_data(receivedData);  // Verwerk de ontvangen gegevens
    memset(receivedData, 0, BUFFER_SIZE);  // Clear de buffer na verwerking
    receivedLength = 0;
  }
}

// Functie om de ontvangen data te parsen
void parse_received_data(char* data)
{


    sscanf(data,
           "STROOM_S1=%f;STROOM_S2=%f;STROOM_S3=%f;THD_S1_RMS=%f;THD_S1_3H=%d;THD_S1_5H=%d;"
           "THD_S1_7H=%d;THD_S1_9H=%d;THD_S1_11H=%d;THD_S1_13H=%d;"
           "THD_S2_RMS=%f;THD_S2_3H=%d;THD_S2_5H=%d;THD_S2_7H=%d;THD_S2_9H=%d;THD_S2_11H=%d;THD_S2_13H=%d;"
           "THD_S3_RMS=%f;THD_S3_3H=%d;THD_S3_5H=%d;THD_S3_7H=%d;THD_S3_9H=%d;THD_S3_11H=%d;THD_S3_13H=%d;",
           &stroom_s1, &stroom_s2, &stroom_s3,
           &thd_s1_rms, &thd_s1_3h, &thd_s1_5h, &thd_s1_7h, &thd_s1_9h, &thd_s1_11h, &thd_s1_13h,
           &thd_s2_rms, &thd_s2_3h, &thd_s2_5h, &thd_s2_7h, &thd_s2_9h, &thd_s2_11h, &thd_s2_13h,
           &thd_s3_rms, &thd_s3_3h, &thd_s3_5h, &thd_s3_7h, &thd_s3_9h, &thd_s3_11h, &thd_s3_13h);

    // Bereken alle gewenste testscenario's
    for (int i = 1; i <= 6; i++) {
        select_test_scenario(i);
    }

    // Zet het eerste scenario klaar
    current_sine_wave_A = sine_wave_A_scenario[0];
    current_sine_wave_B = sine_wave_B_scenario[0];
    current_sine_wave_C = sine_wave_C_scenario[0];
    current_scenario = 1;

    // Update status naar gereed
    update_status(STATUS_GEREED);


}
/* USB_GUI_ CODE END*/


/* USER CODE END 0 */

/**
  * @brief  The application entry point.
  * @retval int
  */
int main(void)
{
  /* MCU Configuration--------------------------------------------------------*/

  /* Reset of all peripherals, Initializes the Flash interface and the Systick. */
  HAL_Init();

  /* Configure the system clock */
  SystemClock_Config();

  /* Initialize all configured peripherals */
  MX_GPIO_Init();
  MX_USART1_UART_Init();
  MX_USART3_UART_Init();
  MX_TIM2_Init();
  MX_I2S1_Init();
  MX_SPI2_Init();
  /* USER CODE BEGIN 2 */

  MX_USB_DEVICE_Init();
  SET_refference();
  DAC8564_Wake_up();
  usb_busy = true;

  while (!(HAL_GPIO_ReadPin(GPIO_PORT_VBUS, GPIO_PIN_VBUS) == GPIO_PIN_SET));
  HAL_Delay (3000);
  receive_settings_and_update_status();



  HAL_GPIO_WritePin(GPIOB, SPI_SYNC_Pin, GPIO_PIN_SET);
  HAL_Delay(150);
  HAL_GPIO_WritePin(GPIOB, SPI_SYNC_Pin, GPIO_PIN_SET);
  HAL_Delay(10);








  /* USER CODE END 2 */

  /* Init scheduler */
  osKernelInitialize();

  /* USER CODE BEGIN RTOS_MUTEX */
  /* add mutexes, ... */
  /* USER CODE END RTOS_MUTEX */

  /* USER CODE BEGIN RTOS_SEMAPHORES */
  /* add semaphores, ... */
  /* USER CODE END RTOS_SEMAPHORES */

  /* USER CODE BEGIN RTOS_TIMERS */
  /* start timers, add new ones, ... */
  /* USER CODE END RTOS_TIMERS */

  /* USER CODE BEGIN RTOS_QUEUES */
  /* add queues, ... */
  /* USER CODE END RTOS_QUEUES */

  /* Create the thread(s) */
  /* creation of defaultTask */
  defaultTaskHandle = osThreadNew(StartDefaultTask, NULL, &defaultTask_attributes);

  /* creation of KnopTASK */
  KnopTASKHandle = osThreadNew(KnopThread, NULL, &KnopTASK_attributes);

  /* creation of LedTASK */
  LedTASKHandle = osThreadNew(Status_Thread, NULL, &LedTASK_attributes);

  /* creation of Active_TASK */
  Active_TASKHandle = osThreadNew(Display_ACTIVE_scenario, NULL, &Active_TASK_attributes);

  /* USER CODE BEGIN RTOS_THREADS */
  /* add threads, ... */
  /* USER CODE END RTOS_THREADS */

  /* USER CODE BEGIN RTOS_EVENTS */
  /* add events, ... */
  /* USER CODE END RTOS_EVENTS */

  /* Start scheduler */
  osKernelStart();
  /* We should never get here as control is now taken by the scheduler */
  /* Infinite loop */
  /* USER CODE BEGIN WHILE */
  while (1)
  {
    /* USER CODE END WHILE */

    /* USER CODE BEGIN 3 */
  }
  /* USER CODE END 3 */
}

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
/* USER CODE BEGIN Header_StartDefaultTask */
/**
  * @brief  Function implementing the defaultTask thread.
  * @param  argument: Not used
  * @retval None
  */
/* USER CODE END Header_StartDefaultTask */
void StartDefaultTask(void *argument)
{
  /* init code for USB_DEVICE */

  /* USER CODE BEGIN 5 */


  /* Infinite loop */
  for(;;)
  {

    osDelay(100000);
  }
  /* USER CODE END 5 */
}

/* USER CODE BEGIN Header_KnopThread */
/**
* @brief Function implementing the KnopTASK thread.
* @param argument: Not used
* @retval None
*/
/* USER CODE END Header_KnopThread */
void KnopThread(void *argument)
{
  /* USER CODE BEGIN KnopThread */
  /* Infinite loop */
	for(;;) {
		if (HAL_GPIO_ReadPin(START_KNOP_PORT, START_KNOP_PIN) == GPIO_PIN_RESET) {
		update_status(STATUS_TEST_GESTART);
		} else if (HAL_GPIO_ReadPin(PAUZEER_KNOP_PORT, PAUZEER_KNOP_PIN) == GPIO_PIN_RESET) {
		update_status(STATUS_TEST_GEPAUZEERD);
		} else if (HAL_GPIO_ReadPin(STOP_KNOP_PORT, STOP_KNOP_PIN) == GPIO_PIN_RESET) {
		update_status(STATUS_TEST_GESTOPT);
		}

	   osDelay(100);

	}
  /* USER CODE END KnopThread */
}

/* USER CODE BEGIN Header_Status_Thread */
/**
* @brief Function implementing the LedTASK thread.
* @param argument: Not used
* @retval None
*/
/* USER CODE END Header_Status_Thread */
void Status_Thread(void *argument)
{
  /* USER CODE BEGIN Status_Thread */
  TestStatus vorige_status = STATUS_IDLE;  // Houdt de vorige stat
  /* Infinite loop */
    for(;;) {
    	 if (huidig_status != vorige_status) {


    	      // Zet de vlag op true om de USB-communicatie te reserveren
    		 usb_busy = true;

    	          // De status is veranderd, voer de eenmalige acties uit
    	          switch (huidig_status) {
    	              case STATUS_WACHTEN_OP_INSTELLINGEN:
    	                  send_status_to_gui(WAITING_FOR_SETTINGS);  // Verstuur slechts één keer
    	                  break;
    	              case STATUS_GEREED:
    	                  send_status_to_gui(READY_STATUS);
    	                  zet_blauw_licht_aan();
    	                  break;
    	              case STATUS_TEST_GESTART:
    	                  send_status_to_gui(TEST_RUNNING);
    	                  zet_groen_licht_aan();  // Groene LED aan, maar niet knipperend
    	                  if (!(vorige_status ==STATUS_TEST_GEPAUZEERD)){
							  if (HAL_TIM_Base_Start_IT(&htim2) != HAL_OK) {
								  Error_Handler();
							  }
    	                  }
    	            	  usb_busy = false;
    	                  break;
    	              case STATUS_TEST_GEPAUZEERD:
    	                  send_status_to_gui(TEST_PAUSED);  // Verstuur status slechts één keer
    	                  // Knipperende actie wordt hieronder periodiek uitgevoerd
    	                  break;
    	              case STATUS_TEST_GESTOPT:
    	            	  if (HAL_TIM_Base_Stop_IT(&htim2) != HAL_OK) {
    	            	      Error_Handler();
    	            	  }
    	                  send_status_to_gui(TEST_STOPPED);
    	                  zet_rood_licht_aan();  // Rode LED aan
    	                  current_scenario = 1;
    	                  break;
    	              case STATUS_TEST_VOLTOOID:
    	                  send_status_to_gui(TEST_COMPLETED);  // Verstuur status slechts één keer
    	                  // Knipperende actie wordt hieronder periodiek uitgevoerd
    	                  break;
    	              default:
    	                  break;
    	          }

    	          // Update de vorige status na het uitvoeren van de actie
    	          vorige_status = huidig_status;


    	      }

    	      // Periodieke acties (knipperende LEDs) blijven elke 100 ms draaien, ongeacht statusverandering
    	      switch (huidig_status) {
    	          case STATUS_TEST_GEPAUZEERD:
    	              groen_knipperend();  // Groen knipperen terwijl gepauzeerd
    	              break;
    	          case STATUS_TEST_VOLTOOID:
    	              blauw_knipperend();  // Blauw knipperen als voltooid
    	              break;
    	          default:
    	              // Geen knipperende LED's in andere statussen
    	              break;
    	      }

    	      // Delay van 100 ms om knipperen te laten werken en CPU te sparen
    	      osDelay(100);
    }
  /* USER CODE END Status_Thread */
}

/* USER CODE BEGIN Header_Display_ACTIVE_scenario */
/**
* @brief Function implementing the Active_TASK thread.
* @param argument: Not used
* @retval None
*/
/* USER CODE END Header_Display_ACTIVE_scenario */
void Display_ACTIVE_scenario(void *argument)
{
  /* USER CODE BEGIN Display_ACTIVE_scenario */
	int vorige_scenario=0;
  /* Infinite loop */
  for(;;)
  {

	  if (huidig_status == STATUS_TEST_GESTART && usb_busy == false && !(vorige_scenario == current_scenario)) {
		  osDelay(20);
		  usb_busy = true;
		  send_active_scenario_to_gui(current_scenario);
		  usb_busy = false;
		  vorige_scenario=current_scenario;

	  }
    osDelay(100);
  }
  /* USER CODE END Display_ACTIVE_scenario */
}

/**
  * @brief  This function is executed in case of error occurrence.
  * @retval None
  */
void Error_Handler(void)
{
  /* USER CODE BEGIN Error_Handler_Debug */
  /* User can add his own implementation to report the HAL error return state */
  __disable_irq();
  while (1)
  {
  }
  /* USER CODE END Error_Handler_Debug */
}

#ifdef  USE_FULL_ASSERT
/**
  * @brief  Reports the name of the source file and the source line number
  *         where the assert_param error has occurred.
  * @param  file: pointer to the source file name
  * @param  line: assert_param error line source number
  * @retval None
  */
void assert_failed(uint8_t *file, uint32_t line)
{
  /* USER CODE BEGIN 6 */
  /* User can add his own implementation to report the file name and line number,
     ex: printf("Wrong parameters value: file %s on line %d\r\n", file, line) */
  /* USER CODE END 6 */
}
#endif /* USE_FULL_ASSERT */
