1012276/AFS30_testsysteem_Stedin/STM32cube_IDE/Final code/Core/Inc/main.h

#define Start_knop_Pin GPIO_PIN_13
#define Start_knop_GPIO_Port GPIOC
#define Pauzeer_knop_Pin GPIO_PIN_14
#define Pauzeer_knop_GPIO_Port GPIOC
#define Stop_knop_Pin GPIO_PIN_15
#define Stop_knop_GPIO_Port GPIOC
#define Blauwe_LED_Pin GPIO_PIN_1
#define Blauwe_LED_GPIO_Port GPIOF
#define Groene_LED_Pin GPIO_PIN_2
#define Groene_LED_GPIO_Port GPIOF
#define Rode_LED_Pin GPIO_PIN_3
#define Rode_LED_GPIO_Port GPIOF
#define VCOM_TX_STLINK_Pin GPIO_PIN_10
#define VCOM_TX_STLINK_GPIO_Port GPIOB
#define VCOM_RX_ST_LINK_Pin GPIO_PIN_11
#define VCOM_RX_ST_LINK_GPIO_Port GPIOB
#define SPI_SYNC_Pin GPIO_PIN_12
#define SPI_SYNC_GPIO_Port GPIOB
#define LDAC_Pin GPIO_PIN_10
#define LDAC_GPIO_Port GPIOD
#define RE_tranceiver_Pin GPIO_PIN_4
#define RE_tranceiver_GPIO_Port GPIOB
#define DE_tranceiver_Pin GPIO_PIN_5
#define DE_tranceiver_GPIO_Port GPIOB
