1012276/AFS30_testsysteem_Stedin/(commit log)

2024-06-03 Altium files toegevoegd aan github
    Alle schema files en PCB-design files zijn toegevoegd aan de repository.
    [DAC.SchDoc, DAC_filter_stage.SchDoc, MCU.SchDoc, RS485_tranceiver.SchDoc, TOP_scheet.SchDoc, User_interface.SchDoc, VOEDING.SchDoc]
2024-09-17 STm32CUBIDE mappen aangemaakt. USB code toegevoegd
    Er zijn verschillende mappen toegevoegd aan de origin waarin de STM32Cube IDE-projecten zullen komen, zowel voor unit-tests, integratietests als de hoofdsoftware. In deze commit is alleen de USB unit-testcode toegevoegd.
2024-09-20 USB code toegevoegd voor GUI en GUI python code geupdate
    USB code van STM32CUBE IDE toegevoegd. Die GUI data verwerkt. Daarnaast ook de GUI python code verder bijgewerkt, dat ook de gebruiker een standaard testprocedure kan initieren.
2024-09-23 Update Test_GUI_Code.py
    Werkende code voor GUI met de volgende functies:
    - Default waarde voor de invoerveld is 0
    - Je krijg de juiste foutmelding als je onjuiste waarde invult
    - De gebruiker kan een standaardprocedure initieeren
2024-09-24 Unittest code STM32, stuurt status van systeem door naar GUI en onvant alle data correct
    GUI code in STM32 unittest geupdate.
    Deze versie bevat de volgende functionaliteiten:
    - Heeft functies om de status van het systeem door te geven zodat de gebruiker dit kan zien.
    - ontvangt de verzonden instellingen correct en slaat deze op!
    [main.c]
2024-09-24 VScode GUI code geupdate. Status balk toegevoegd aan GUI
    Bij deze versie heeft de GUI alle vorige functionaliteiten behouden, alleen is functie statusbalk toegevoegd!
2024-09-25 GUI code 90% af. Actief testscenario kan weergeven worden
    Bij deze versie kan de actieve testscenario weergeven worden via de GUI. Deze versie bevat de volgende functionaliteiten:
    - Gebruikeren kan parameters instellen en krijgt een warning als dit goed is gedaan.
    -Standaard testrpocedure starten
    - De statussen van de systeem worden weergeven
    - De actieve testscenario wordt weergeven
2024-09-26 Werkende code Userinterface voor unittest. STM32
    In deze versie van de code, werken de taken goed en werkt de userinterface prima
2024-09-28 De integratietestcode werkend gekregen van de GUI en de Userinterface
    In deze versie van de code. Is de code van de GUI geïntegreerd met de Userinterface.
    - Bij deze code wordt een echte testprocedure gesimuleert. Er is ook een thread die DAC simuleert en elk 5 seconden dus van testscenario wisselt. Tijdens de testprocedure kun je de tesptrocedure regelen doormiddel van de drukknoppen.
    - De status van het systeem wordt goed weergeven door de RGB LED en de GUI.
    - De drukknopen werken prima
    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
2024-10-02 DAC unittest code die om de hoeveelheid seconden van scenario wisselt!
    Bij deze code wisselt de DAC van elk scenario binnen 5 seconden!
2024-10-02 Integratietest code voor userinterface en USB
    Bij deze versie van de code is de integratietest van de userinterface en USB uitgevoerd
2024-10-03 De werkende integratie code met alle deelsystemen
    Bij deze commit is de integratie code helemaal werkend. Deze versie van de code werkt met de userinterface met de DAC en met de GUI via USB. Bij deze code kan ook de testprocedure gepauzeerd worden en wordt huidige testscenario correct weergeven.
    [Test_GUI_Code.py, main.c, main.h]
2024-10-20 Alle PCB-bestanden en fabricatiebestanden van PCB versie 2 zijn geüpload.
    Bij deze commit zijn alle hardwarebestanden van PCB versie 2 geüpload. Dit omvat:
    BOM (Bill of Materials)
    Fabricatiebestanden: Gerber/Drill en CPL-bestanden
    PCB-project, schema en PCB-document
    PDF van het schema
    [DAC.SchDoc, DAC_filter_stage.SchDoc, MCU.SchDoc, Pick Place for Testopstelling_DA_BOX_STEDIN_V2.csv, RS485_tranceiver.SchDoc, TOP_scheet.SchDoc, TOP_sheet.SchDoc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]
2024-10-20 De final code van het testsysteem is geüpload.
    In deze versie van de code zijn alle deelsystemen geïntegreerd. Alleen de communicatie met het Smart Device via MODBUS ontbreekt nog.
    De testprocedure duurt 12 seconden per scenario.
2024-10-28 Aanpassing namen van variabelen
    Er zijn kleine aanpassingen gemaakt in de namen van de variabelen en functies om de functie van de variabelen te verduidelijken.
2024-10-28 Unittest DAC code van de eerste ontwerp toegevoegd
2024-11-08 Aanpassingen gedaan in de comments
