1012276/AFS30_testsysteem_Stedin/(notices)

Notices in the files:
STM32cube_IDE/Final code/Core/Inc/main.h:
Copyright (c) 2024 STMicroelectronics.
All rights reserved.
This software is licensed under terms that can be found in the LICENSE file
